0xCB-dev/0xCB-Pluto/rev1.0/pluto.pdf

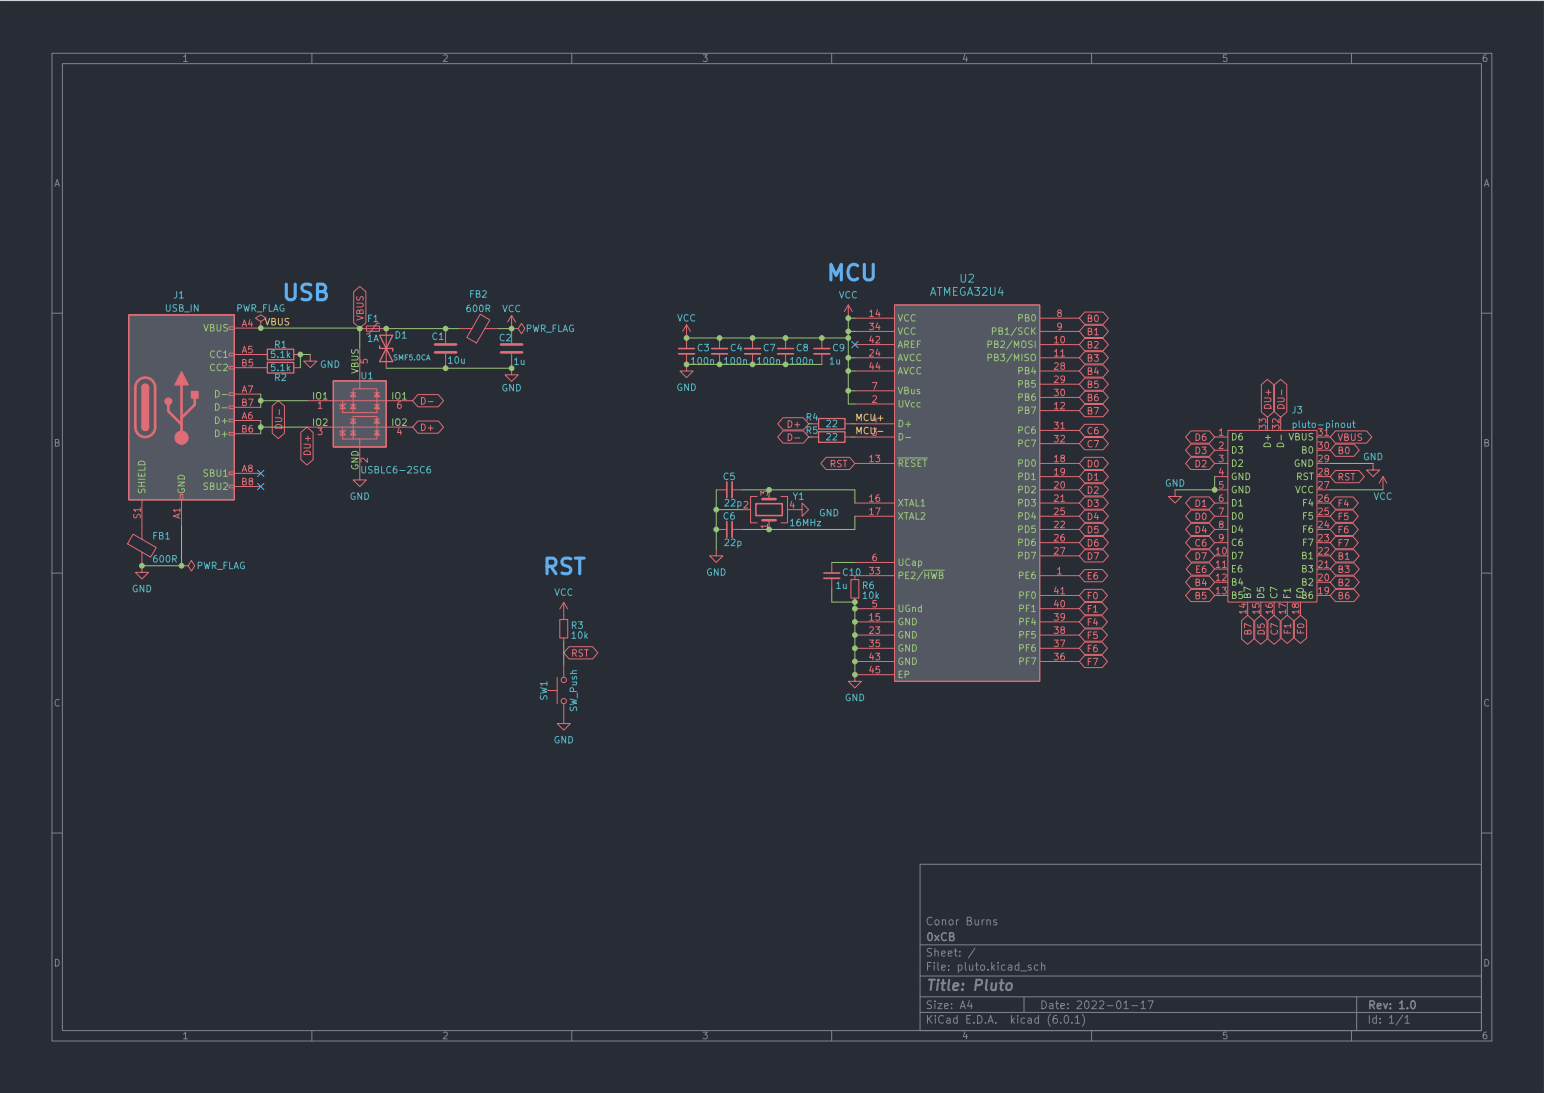
[picture p3: page 1]
