0xCB-dev/0xCB-Pluto/(threads)

Thread 2 (2022-11-03):

Component Placement List

atanasj, 2022-11-03:
Hi,

Thanks for this project.

I am trying to get this printed and assembled by JLCPCP, something I have never done before. I have the BOM from the readme, but was wondering if anyone had something like a components placement list with the XY coordinates of the or the components?

Cheers,
Atanas

atanasj, 2022-11-04:
Actually, I figured this out from the KiCAD help files, pays to read the docs! However, I am struggling to find some of the parts e.g., molex2169900001 for the USB_IN. Do you know of any other alternatives readily available via JLCPCB?
