0xCB-dev/0xCB-Pluto/(commit log)

2022-01-19 placed some components
    [pluto.kicad_pcb]
2022-01-19 fixed constraints
    [pluto.kicad_pcb]
2022-01-21 placed some components and fixed layout
    [pluto.kicad_pcb, pluto.kicad_sch]
2022-01-22 connected all components
    [pluto.kicad_pcb]
2022-01-23 fixed VCC, removed GND plane. wired GND individually, removed ISP
    [micro.wrl.SLDPRT, pluto.kicad_pcb, pluto.kicad_sch]
2022-01-23 added rest button that might fit and fixed skew of data lines
    [pluto.kicad_pcb, pluto.kicad_sch]
2022-01-23 final touches
    rounded traces. teardrops, cleaned up a bit
    [pluto.kicad_pcb]
2022-01-23 ready for prod
    [micro.wrl.SLDPRT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]
2022-01-23 fixed case in readme link
2022-01-26 fixed teardrops
    [pluto.kicad_pcb]
2022-09-10 Silkscreen fix, E0->F0
    [pluto.kicad_pcb]
